Resoron/medication-dispenser/production/BOM.csv

Id | Designator | Footprint | Quantity | Designation | Supplier and ref
1 | Boot1, Reset1 | SW_SPST_EVQPE1 | 2 | EVQ-PE104K
2 | C1, C6, C7 | CAPC1005X55N | 3 | CC0402KRX7R7BB104
3 | C2, C8 | CAPC1608X90N | 2 | CL10A105KO8NNNC
4 | C3 | RESC3216X125N | 1 | T491A106K016AT
5 | C4, C9, C10 | CAPC2012X135N | 3 | GRM21BR61C106KE15L
6 | C5 | CP_Radial_D8.0mm_P3.50mm | 1 | ECA1CM471
7 | D2 | LED_APT2012SURCK | 1 | APT2012SURCK
8 | J2, J3, J4, J5 | JST_XH_B5B-XH-A_1x05_P2.50mm_Vertical | 4 | Conn_01x05
9 | J6 | JST_XH_B4B-XH-A_1x04_P2.50mm_Vertical | 1 | Conn_01x04
10 | J7 | USB_C_Receptacle_GCT_USB4105-xx-A_16P_TopMnt_Horizontal | 1 | USB_C_Receptacle_USB2.0_16P
11 | Q1, Q2 | SOT-23 | 2 | BSS138
12 | R1, R2, R6, R7 | RESC1005X40N | 4 | RC0402FR-0710KL
13 | R3, R4 | R_0805_2012Metric_Pad1.20x1.40mm_HandSolder | 2 | RC0805FR-075K1L
14 | R5 | RESC1005X40N | 1 | RC0402FR-07330RL
15 | S1, S2, S3 | JST_XH_B2B-XH-A_1x02_P2.50mm_Vertical | 3 | Conn_01x02
16 | U1 | SOT230P700X175-4N | 1 | NCP1117LPST33T3G
17 | U2, U5 | SOIC-18W_7.5x11.6mm_P1.27mm | 2 | ULN2803A
18 | U3 | ESP32-S3-WROOM-1 | 1 | ESP32-S3-WROOM-1-N8
19 | U4 | SOT-23-6 | 1 | USBLC6-2SC6
