Resoron/medication-dispenser/hardware/Medication_System_Final.kicad_pcb

## KiCad design hardware/Medication_System_Final.kicad_pcb (2026-11-01)

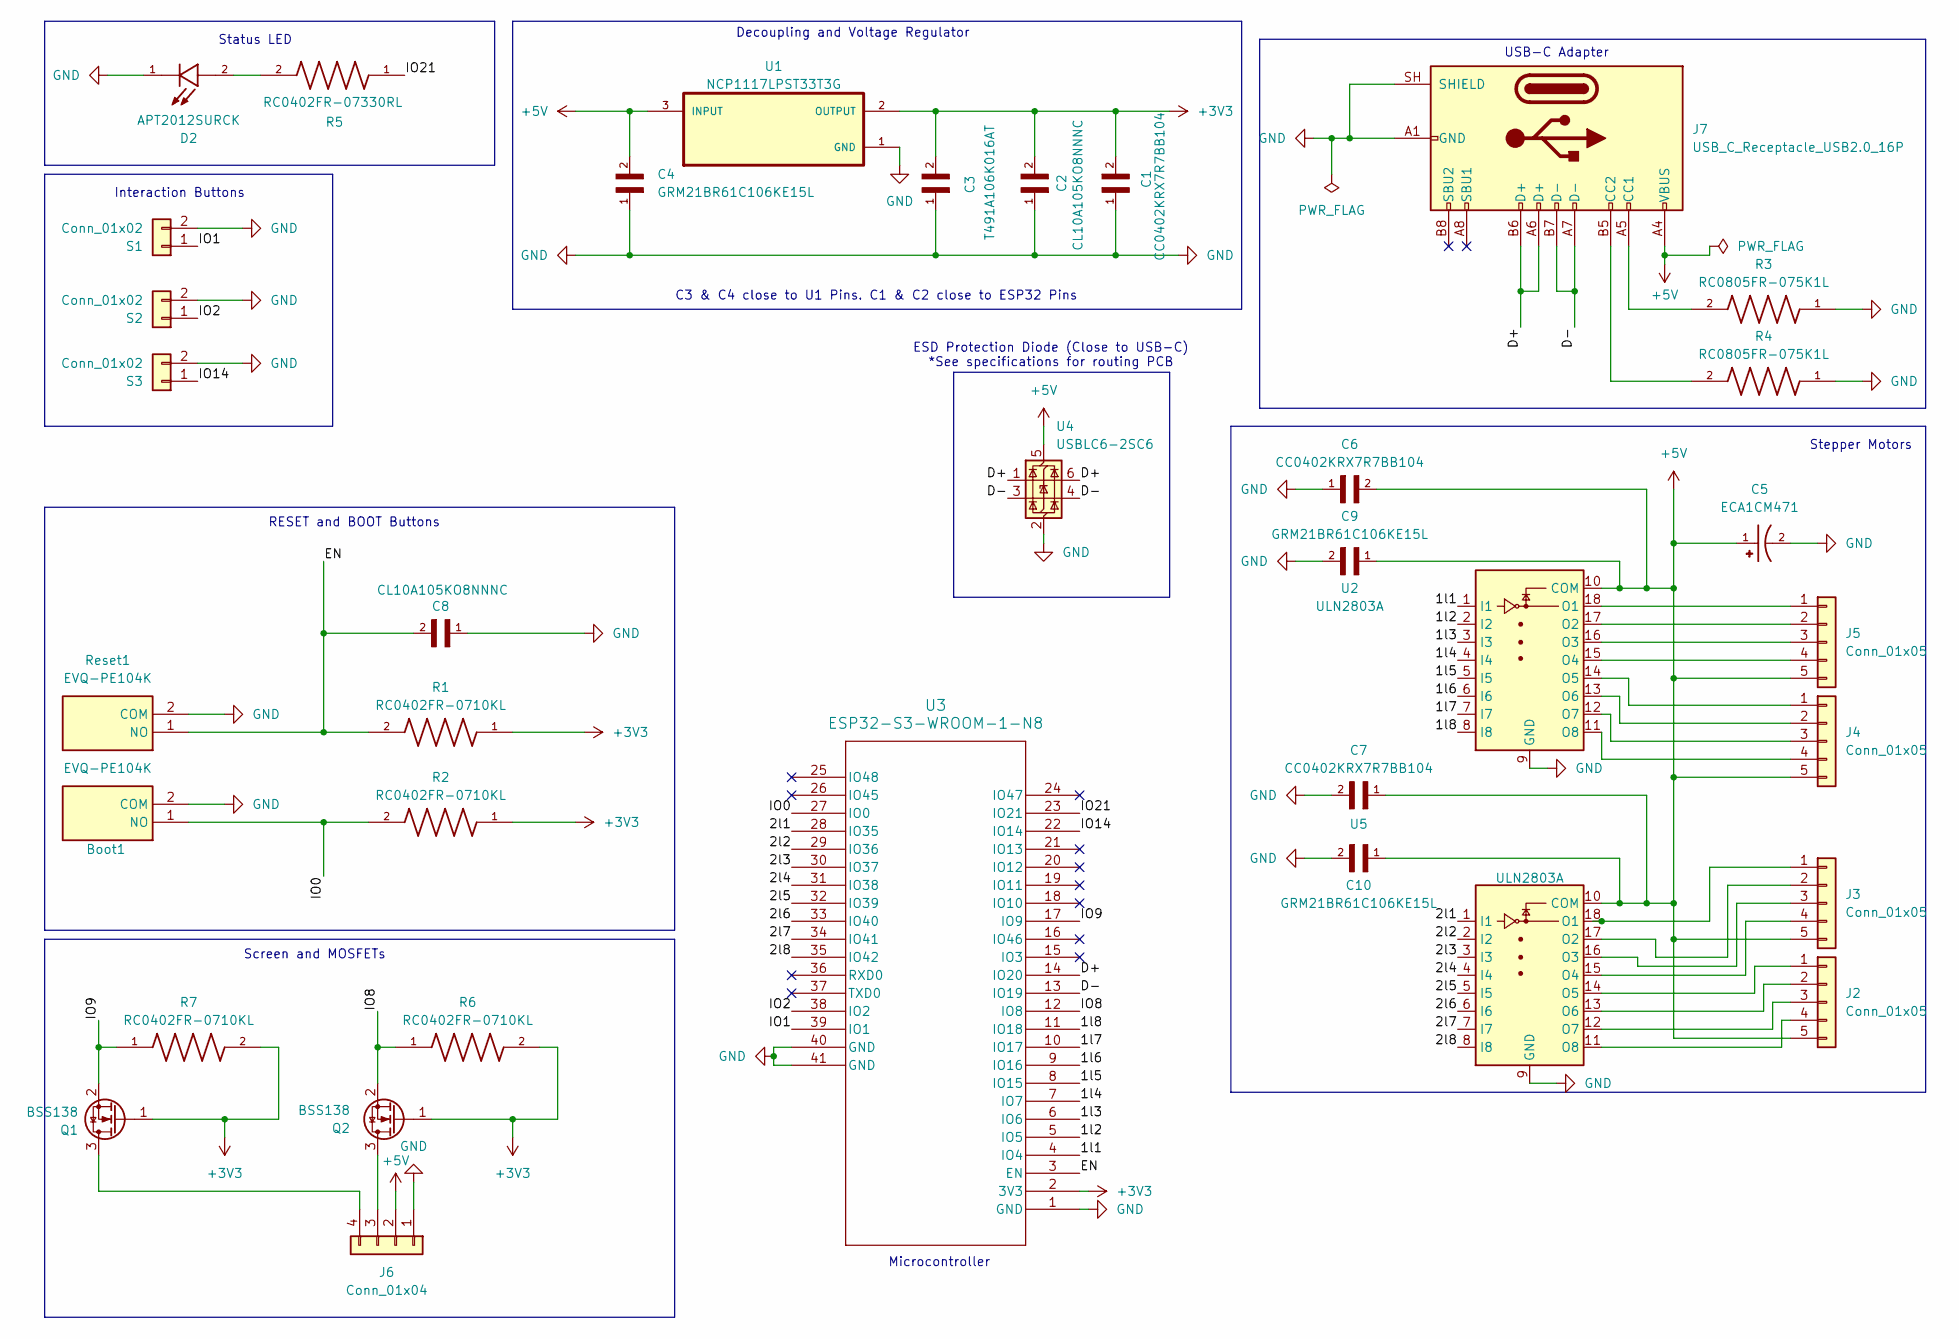
[picture p1: schematic Medication_System_Final.kicad_sch, Medication Dispenser PCB]

Parts:
Boot1: EVQ-PE104K; SW_SPST_EVQPE1; Mouser Part Number 667-EVQ-PE104K
C1, C6, C7: CC0402KRX7R7BB104; CAPC1005X55N
C2, C8: CL10A105KO8NNNC; CAPC1608X90N
C3: T491A106K016AT; RESC3216X125N
C4, C9, C10: GRM21BR61C106KE15L; CAPC2012X135N
C5: ECA1CM471; CP_Radial_D8.0mm_P3.50mm; PARTREV 20-DEC-19
D2: APT2012SURCK; LED_APT2012SURCK; PARTREV V.20B; DigiKey_Part_Number 754-1133-1-ND
J2, J3, J4, J5: Conn_01x05; JST_XH_B5B-XH-A_1x05_P2.50mm_Vertical
J6: Conn_01x04; JST_XH_B4B-XH-A_1x04_P2.50mm_Vertical
J7: USB_C_Receptacle_USB2.0_16P; USB_C_Receptacle_GCT_USB4105-xx-A_16P_TopMnt_Horizontal
Q1, Q2: BSS138; SOT-23
R1, R2, R6, R7: RC0402FR-0710KL; RESC1005X40N; PARTREV V.12; DigiKey_Part_Number 311-10.0KLRCT-ND
R3, R4: RC0805FR-075K1L; R_0805_2012Metric_Pad1.20x1.40mm_HandSolder
R5: RC0402FR-07330RL; RESC1005X40N; DigiKey_Part_Number 311-330LRCT-ND
Reset1: EVQ-PE104K; SW_SPST_EVQPE1; Mouser Part Number 667-EVQ-PE104K
S1, S2, S3: Conn_01x02; JST_XH_B2B-XH-A_1x02_P2.50mm_Vertical
U1: NCP1117LPST33T3G; SOT230P700X175-4N; DigiKey_Part_Number NCP1117LPST33T3GOSCT-ND
U2, U5: ULN2803A; SOIC-18W_7.5x11.6mm_P1.27mm
U3: ESP32-S3-WROOM-1-N8; ESP32-S3-WROOM-1
U4: USBLC6-2SC6; SOT-23-6

Connections:
+3V3: C1.2, C2.2, C3.2, Q1.1 (G), Q2.1 (G), R1.1, R2.1, R6.2, R7.2, U1.2 (OUTPUT), U1.4 (OUTPUT), U3.2 (3V3)
+5V: C4.2, C5.1, C6.2, C7.1, C9.1, C10.1, J2.5, J3.5, J4.5, J5.5, J6.2, J7.A4 (VBUS), J7.A9 (VBUS), J7.B4 (VBUS), J7.B9 (VBUS), U1.3 (INPUT), U2.10 (COM), U4.5 (VBUS), U5.10 (COM)
/1l1: U2.1 (I1), U3.4 (IO4)
/1l2: U2.2 (I2), U3.5 (IO5)
/1l3: U2.3 (I3), U3.6 (IO6)
/1l4: U2.4 (I4), U3.7 (IO7)
/1l5: U2.5 (I5), U3.8 (IO15)
/1l6: U2.6 (I6), U3.9 (IO16)
/1l7: U2.7 (I7), U3.10 (IO17)
/1l8: U2.8 (I8), U3.11 (IO18)
/2l1: U3.28 (IO35), U5.1 (I1)
/2l2: U3.29 (IO36), U5.2 (I2)
/2l3: U3.30 (IO37), U5.3 (I3)
/2l4: U3.31 (IO38), U5.4 (I4)
/2l5: U3.32 (IO39), U5.5 (I5)
/2l6: U3.33 (IO40), U5.6 (I6)
/2l7: U3.34 (IO41), U5.7 (I7)
/2l8: U3.35 (IO42), U5.8 (I8)
/D+: J7.A6 (D+), J7.B6 (D+), U3.14 (IO20), U4.1 (I/O1), U4.6 (I/O1)
/D-: J7.A7 (D-), J7.B7 (D-), U3.13 (IO19), U4.3 (I/O2), U4.4 (I/O2)
/EN: C8.2, R1.2, Reset1.1 (NO), U3.3 (EN)
/IO0: Boot1.1 (NO), R2.2, U3.27 (IO0)
/IO1: S1.1, U3.39 (IO1)
/IO2: S2.1, U3.38 (IO2)
/IO8: Q2.2 (S), R6.1, U3.12 (IO8)
/IO9: Q1.2 (S), R7.1, U3.17 (IO9)
/IO14: S3.1, U3.22 (IO14)
/IO21: R5.1, U3.23 (IO21)
GND: Boot1.2 (COM), C1.1, C2.1, C3.1, C4.1, C5.2, C6.1, C7.2, C8.1, C9.2, C10.2, D2.1, J6.1, J7.A1 (GND), J7.A12 (GND), J7.B1 (GND), J7.B12 (GND), J7.SH (SHIELD), R3.1, R4.1, Reset1.2 (COM), S1.2, S2.2, S3.2, U1.1 (GND), U2.9 (GND), U3.1 (GND), U3.40 (GND), U3.41 (GND), U4.2 (GND), U5.9 (GND)
unnamed: D2.2, R5.2
unnamed: J2.1, U5.14 (O5)
unnamed: J2.2, U5.13 (O6)
unnamed: J2.3, U5.12 (O7)
unnamed: J2.4, U5.11 (O8)
unnamed: J3.1, U5.18 (O1)
unnamed: J3.2, U5.17 (O2)
unnamed: J3.3, U5.16 (O3)
unnamed: J3.4, U5.15 (O4)
unnamed: J4.1, U2.14 (O5)
unnamed: J4.2, U2.13 (O6)
unnamed: J4.3, U2.12 (O7)
unnamed: J4.4, U2.11 (O8)
unnamed: J5.1, U2.18 (O1)
unnamed: J5.2, U2.17 (O2)
unnamed: J5.3, U2.16 (O3)
unnamed: J5.4, U2.15 (O4)
unnamed: J6.3, Q2.3 (D)
unnamed: J6.4, Q1.3 (D)
unnamed: J7.A5 (CC1), R3.2
unnamed: J7.B5 (CC2), R4.2

Notes on the sheet:
RESET and BOOT Buttons
Decoupling and Voltage Regulator
ESD Protection Diode (Close to USB-C) *See specifications for routing PCB
USB-C Adapter
Status LED
Interaction Buttons
Stepper Motors
Microcontroller
Screen and MOSFETs
C3 & C4 close to U1 Pins. C1 & C2 close to ESP32 Pins

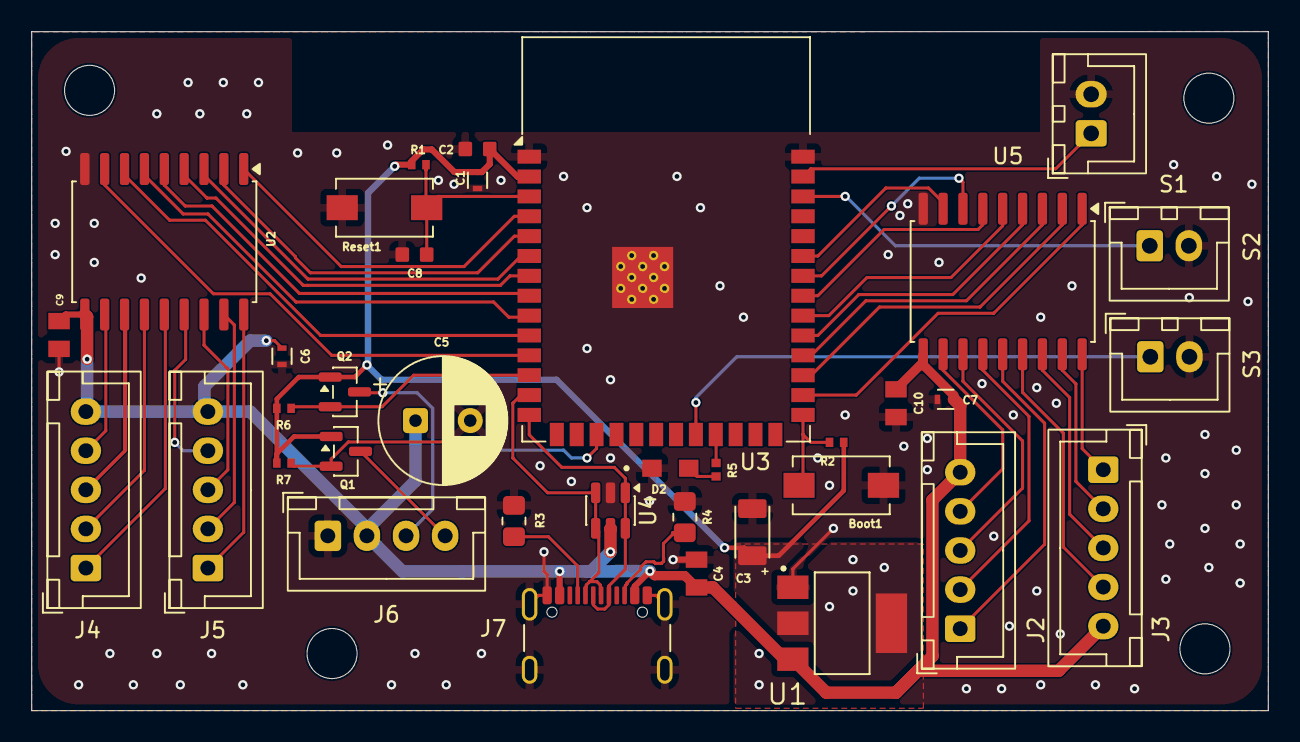
[picture p2: board Medication_System_Final.kicad_pcb from above]

Board: 2 copper layers, 79.1 x 43.4 mm, 36 parts (0 on the bottom side), 50 nets.
