Resoron/medication-dispenser/(commit log)

2026-10-10 Servo version on ESP32-C6
    [Medication_System.kicad_pcb, Medication_System.kicad_sch, Medication_System_4Servo.kicad_pcb]
2026-10-10 Ignore KiCad backups and local history
2026-11-01 Snapshot of pre-final S3/stepper work before reorganizing
    [Medication_System.kicad_pcb, Medication_System.kicad_sch]
2026-11-01 Final ordered design: organize into hardware/ and production/, remove servo versions, add README
    [BOM.csv, Medication_System.kicad_pcb, Medication_System_4Servo.kicad_pcb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]
